kvlh/szambo_zigbee/(commit log)

2026-02-27 Working firmware: ESP32-C6 + VL53L0X + Zigbee + battery ADC
    - ESP-IDF v5.5.2, esp-zigbee-lib 1.6.8, esp-zboss-lib 1.6.4
    - 3 endpoints: distance (mm), battery_voltage (V), measurement_interval (min)
    - Battery ADC: GPIO2/A0, divider 200k+100k, multiplier 2.86
    - Z2M converter: battery_voltage (precision 2), battery_level (%), distance
    - Measurement interval: 60 min default, configurable via Z2M
    - OTA support (manufacturer=0x1001, image_type=0x1011)
    - Light sleep disabled (broken in v1.6.8), deep sleep pending
    [partitions.csv]
2026-02-27 Add deep sleep between measurements
    Replace light sleep (broken in v1.6.8) with ESP32-C6 deep sleep:
    - sensor_task: one-shot task, measures + reports + deep sleeps for interval
    - Deep sleep duration = measurement_interval - active_time (min 55s fallback)
    - 3s post-report window for Z2M to send commands
    - main.c: removed PM light sleep code, added wakeup cause logging
    - sdkconfig: removed PM configs, added POWER_DOWN_FLASH for deep sleep
    - Estimated consumption: ~0.14mA avg → 550mAh ≈ 145 days
    [main.c, sensor_task.c, zigbee_device.c, zigbee_device.h]
2026-02-28 Fix OTA crash: remove explicit query_image_req call
    esp-zboss-lib asserts at zcl_ota_upgrade_commands.c:378 when
    esp_zb_ota_upgrade_client_query_image_req() is called manually.
    The stack sends QueryNextImageRequest automatically after join.
    Bump v4 (flash) -> v5 (OTA image on GitHub).
    [sensor_task.c]
2026-03-01 Read measurement_interval just before sleep (not at wake), bump to v1.0.0.6
    Interval is now read right before esp_deep_sleep_start(), so Z2M writes
    during the wake window take effect in the current sleep cycle.
2026-03-01 Fix OTA: set query_interval=1min on join, extend OTA_CHECK_WAIT to 90s
    Default timer_query=1440 (24h). After deep sleep RAM resets, timer restarts
    from 1440 and device goes back to sleep before query fires. Fix: call
    esp_zb_ota_upgrade_client_query_interval_set(EP_DISTANCE, 1) on join to
    reset timer to 1 minute, and extend wake window to 90s to cover it.
    [sensor_task.c, zigbee_device.c]
2026-03-01 Set OTA client variable timer_query=1min, add v7 for OTA test
    - Add esp_zb_ota_cluster_add_attr(0xfff1) with timer_query=1 at cluster
    creation to override default 24h query interval
    - v7 OTA image = same v6 binary relabeled for end-to-end OTA test
    - Device on v6 should receive v7 via Zigbee OTA automatically
2026-03-01 Fix OTA INVALID_IMAGE: skip 6-byte sub-element header in STATUS_RECEIVE
    ZBOSS in esp-zigbee-lib 1.6.x passes raw Zigbee OTA file bytes including
    the 6-byte sub-element header (tag 0x0000 + 4-byte length) to the
    STATUS_RECEIVE callback. ESP-IDF v5.x esp_ota_write validates the 0xE9
    ESP32 magic byte on the first write and fails if the first byte is 0x00
    (sub-element tag). Fixed by detecting and skipping the header on first block.
    Added first-block diagnostic logging.
    Bump to v1.0.0.7 on device, v1.0.0.8 as new OTA target.
    [sensor_task.c, zigbee_device.c, zigbee_device.h]
2026-03-01 Fix OTA timeout: 10 min → 90 min, bump to v1.0.0.8 (flash) + v1.0.0.9 (OTA)
    OTA transfer takes ~46 min but OTA_TRANSFER_TIMEOUT_US was only 10 min,
    causing the device to sleep mid-transfer and restart from 0 every wake cycle.
    Extended to 90 min so OTA completes in one wake session.
    [sensor_task.c, zigbee_device.h]
2026-03-01 Add comprehensive project documentation (README.md)
    Architecture, endpoints, deep sleep, OTA workflow, build/flash instructions,
    Z2M/HA setup, NVS config, partition layout, and detailed troubleshooting for
    9 problems encountered during development (light sleep, OTA sub-element header
    bug, OTA timer, OTA timeout, zb_storage crash, ESM converter, USB bootloader,
    setsid, permit_join).
2026-03-02 Fix OTA infinite loop: index.json fileVersion must equal firmware's OTA_UPGRADE_FILE_VERSION
    After OTA installs a new image, the running firmware reports
    OTA_UPGRADE_FILE_VERSION to Z2M via QueryNextImageRequest.
    If index.json has a higher fileVersion, Z2M immediately triggers
    another OTA → infinite loop.
    Rule: FILE_VERSION in make_ota.py == OTA_UPGRADE_FILE_VERSION in
    zigbee_device.h == fileVersion in index.json. All three must match.
    To release a new OTA: bump all three by 1 together.
    Revert index.json to v8 (16777224) to match what the running
    firmware actually reports. Loop will stop after current transfer ends.
    [zigbee_device.h]
2026-03-05 Release v1.0.0.10: Nowa obudowa scada, medina ToF i dynamiczny sen
    [obudowa.scad]
